qqqiiieee/fpga_gowin2/docs/V034到V047更新说明.md

# V034 → V047 更新说明

比较基线是仓库上一版提交 `d6295e39ca2d74b82c05a373665e5388a38f060b`，不是仅列 V046 到 V047 的变化。当前固件身份见根目录 manifest；中间版、对话、工具链缓存、Flash 个人数据备份不作为本次发布内容。

| 项目 | V034 | V047 |
|---|---|---|
| 手机 | 参数与预设 | 参数/只读遥测、曲谱上传激活与下载、128 音符映射及 Pad/CC 映射、录音回传 |
| 教学 | 三首固定曲的视觉时间轴 | 一首简单曲+两首复杂练习曲；自动发声、逐音练习、固定 BPM；另有上传自定义槽 |
| 和弦 | 旧单音指引 | score/2 同组 1–4 音、同组下落条、自动和弦、练习新 NoteOn 和同时 held 判定；兼容 score/1 |
| 32 路验证 | 内部引擎存在、生产无启动入口 | 长按3进入，短按4全32；逐路 OFF/ON 检查；频率核对表与展示说明 |
| 可视化 | 波形/音符摘要 | 最终 PCM FFT512、前两声部李萨如及自适应缩放、双 FSR/MIDI/光电诊断 |
| 面板 | 短按及长按1/2 | 增加长按3测试和长按4指导模式；逐页中文操作说明 |
| ADS | D14/E15 | 迁到 PMOD3 N9/N7，避让受损信号脚；增强复位/恢复 |
| 外接 I2S | B14/A15/B13 | B12/C12/B13；保留 PT8211；用户已反馈 I2S 输出实现 |
| Pad | 原混音电平 | 四鼓组 /4→/2，约 +6.02dB；旋律不变、保留饱和保护 |
| MIDI 状态 | 原展开实现 | 位图等价优化；保持完整0–127音域、来源释放、延音、Panic；差分回归已记录 |
| 录音存储 | 无 | LittleFS 顺序写 WAV 数据，readWavRange 合成44字节文件头；修复长录音封口问题 |

保留两种旋律音色、32 独立状态、双光电、双 FSR、四个 FX/音量旋钮。滑杆/MCP/矩阵及电容菜单仍停用；这部分主要变化已在上一版完成，不算本次新删功能。三效果仍互斥，并未增加三条并行效果链。

## 维护重点

1. FPGA/ESP 必须配套。能力字与 score/2 同步，旧 ESP V046 不识别新能力组合；HTTP 接收不等于 FPGA 提交成功。
2. 曲谱最多63组、每组1–4个升序唯一音高、MIDI41–72、四分之一拍网格、共享起始/时长、组间不重叠；不是任意多轨 MIDI。JSON velocity 当前不改变自动演奏固定力度192。
3. guide_chord_events 的来源3先 Off 再 On；guide_chord_modes 要求新触发且同时保持全部目标，踏板尾音不等于真实 held。
4. 映射只改变送合成器的音符；原始琴键高亮、练习判定与扫弦选音仍按物理 MIDI。修改须同时保护排队、NoteOff、延音和 Panic。
5. 录音不得恢复 seek(0) 改写大文件头；所有下载/USB读取走 readWavRange。录音15625Hz不是I2S的93750Hz。
6. N9 是复用脚，重建必须设置 use_sspi_as_gpio=1。禁用损坏脚清单与当前接线见接线文档。
7. 当前已有真实上传/下载、三模式状态与30秒非静音数字录音证据；模拟延迟、32路频谱、真实逐音和弦实弹、冷启动仍待确认。
8. 光电单束后备有150ms等待，不能对全部输入路径宣称≤10ms/≤5ms；应单独测试并改进。FFT/XY是只读监视，不应进入实时音频控制环。

## 资源变化与验证

| 资源 | V034 | V047 | 增量 |
|---|---:|---:|---:|
| Logic |16940|20381|+3441|
| Register |8100|9540|+1440|
| CLS |9510|10353|+843|
| BSRAM |27|41|+14|
| DSP |15.75|16.25|+0.5|

两版 Setup/Hold 均为0；V047主时钟Fmax27.03MHz，CLS余15。既有实机录音468750样本、937544字节、CRC32 a5efac56；这些数字证明数字音频回传，不证明模拟底噪或输入到声音的延迟。

本次 GitHub 发布沿用已验证二进制，不重新编译、不改板上内容。示例谱保持文件形式供手机上传；验证后设备自定义曲库已清空，不把演示新曲预烧进程序。
