qqqiiieee/fpga_gowin2/docs/V045_演奏界面预览.png

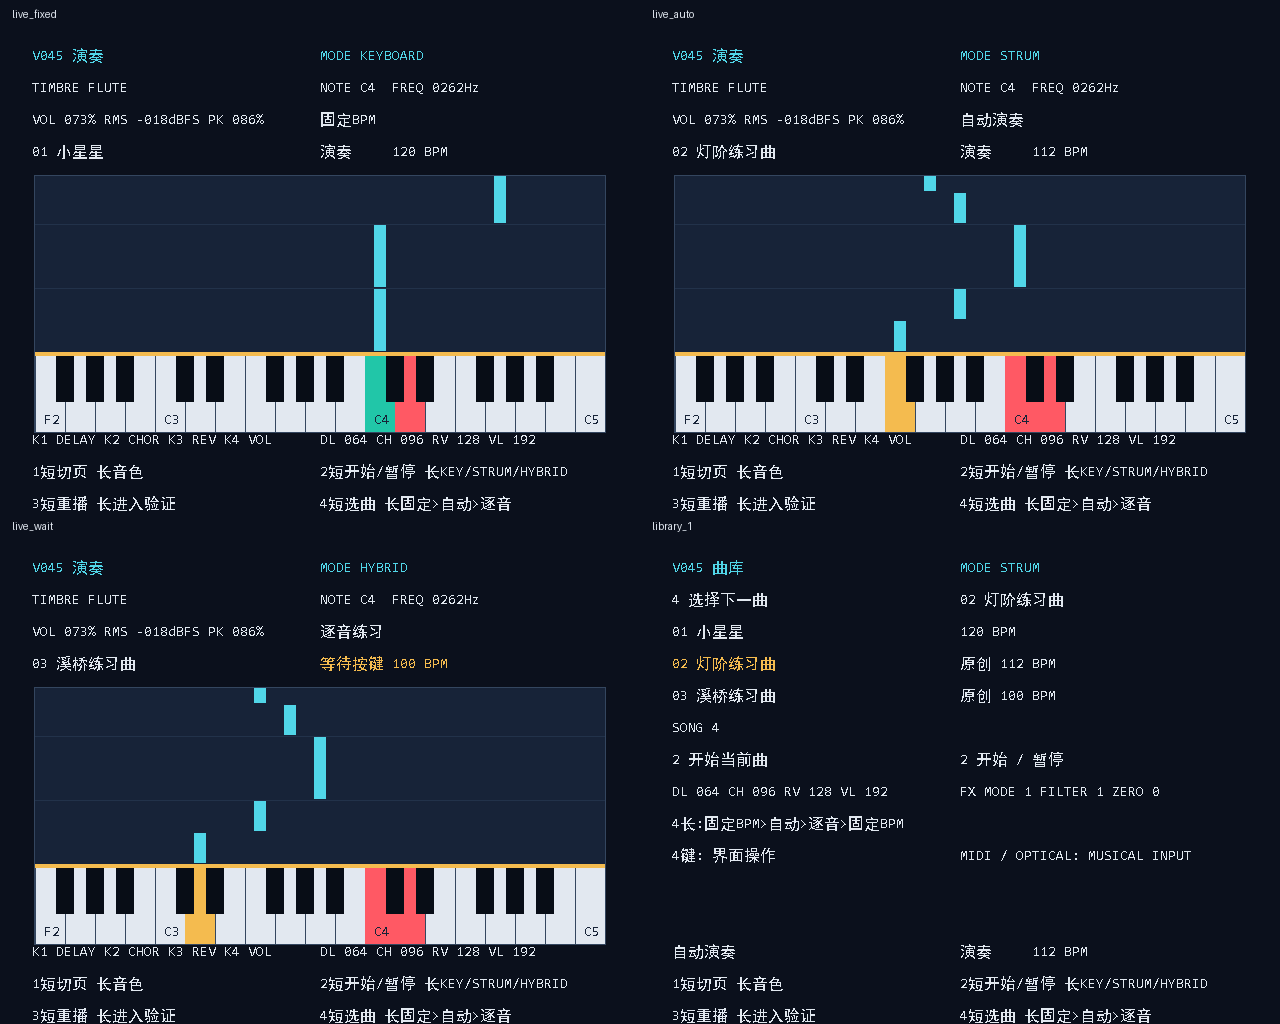
docs/V045_演奏界面预览.png
