qqqiiieee/fpga_gowin2/verification/guide_preview.png

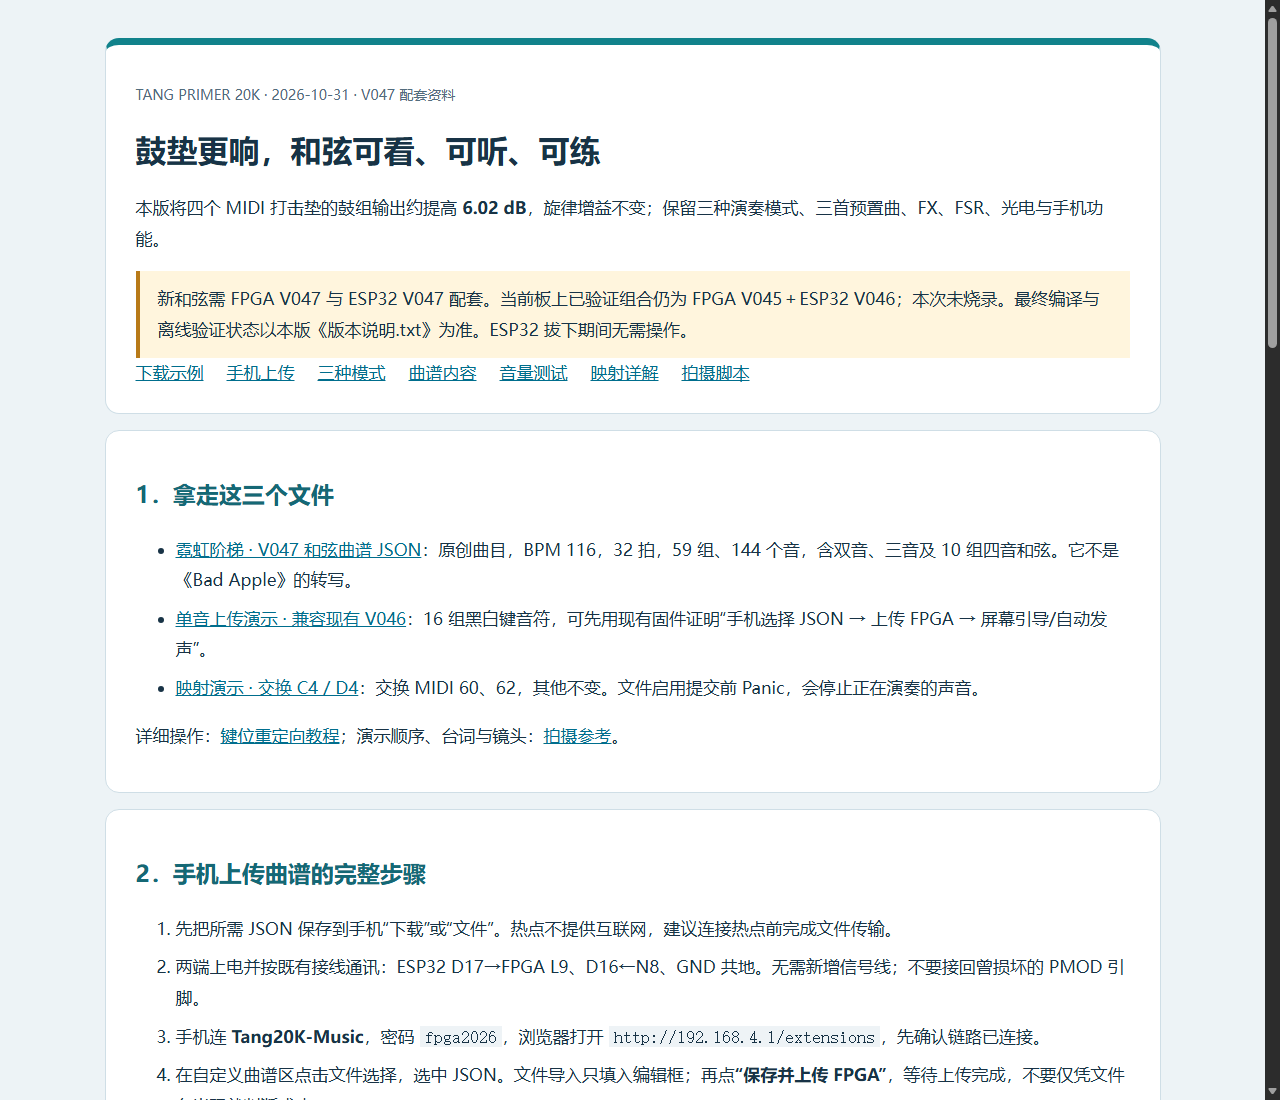
verification/guide_preview.png
