qqqiiieee/fpga_gowin2/tests/pad_gain_v047/README.md

# V047 四 MIDI 鼓垫增益验证

生产改动仅 `src/performance_mixer.v`：`drums_sum >>> 2` 改为 `>>> 1`。
四鼓先有符号求和再统一放大，未改单鼓、力度映射、旋律乘积、平衡平滑、流水线和末级饱和。
默认 balance=128：鼓组由 sum/8 改为 sum/4；旋律仍为 melody/2。
两个原有乘法表达式及所有寄存器位宽保持不变，没有增加乘法器。

## 位宽与真实上游

- 任意四路 PCM16 求和范围 -131072..131068，18 位有符号完整保存。
- 除 2 后 -65536..65534；乘最大平衡 255 后 -16711680..16711170，现有 26 位乘积足够。
- 与旋律在原 27 位加法寄存器相加，最后除 256 并饱和为 -32768..32767，不能先截成 16 位。
- `drum_voice.v` 三角幅值与包络给出绝对峰值 ≤8159；`snare_voice.v` 的噪声+主体 ≤8158；两种 `hat_voice.v` 各 ≤8159。
- 因而真实四鼓即便所有理论峰值同相，总和绝对值 ≤32635，除 2 后在 -16318..16317 内。
  和任意合法旋律 PCM 用互补平衡权重混合不会新增饱和；人为全量程四鼓仍由原饱和器保护。
- MIDI 原映射 `{v7,v7[6]}`、FX 和总音量链路从当前本地源码检查，未改动。

## 本次结果

有效记录：`results/20261031T112653_828232Z/report.json`，也复制到 `latest_report.json`。
采样率按生产音频 93750 Hz 解读；每例 60400 帧覆盖开镲完整尾音及复触发。
以下为冷启动、力度255、默认平衡128，在混音器输出处测量的 PCM 整数幅值：

| 输入 | 真实上游峰值 | 旧输出峰值 | 新输出峰值 | 新输出 RMS |
|---|---:|---:|---:|---:|
| 底鼓 | 7874 | 984 | 1968 | 157.61 |
| 军鼓 | 4875 | 609 | 1218 | 55.32 |
| 闭镲 | 5917 | 740 | 1480 | 85.28 |
| 开镲 | 6081 | 761 | 1521 | 242.90 |
| 四鼓同时 | 20777 | 2597 | 5194 | 349.56 |

上述 RMS 增益均约 +6.02 dB。力度 0/2/64/129/192/255 的四鼓输出峰值分别为
0/40/1303/2627/3910/5194，RMS 严格递增。力度2的 RMS 增益约5.83 dB，源于原有整数右移量化；未改为取绝对值或无符号移位。

- 算术：417903组通过，包括六个平衡点穷举全部65536个旋律值、全部256个平衡码的四鼓符号角点、10000组固定种子随机输入和奇数负值。
- 395524组无鼓输入与冻结旧版逐位相同；复位、无tick保持、三拍后发布/四级处理时序、平衡每帧一码均检查。
- 人工边界命中正饱和520次、负饱和1521次，均符合独立32位整数参考，没有正负回绕。
- 真实四鼓：5073600次逐样本检查，涵盖六档力度、平衡128/255、错开击打、尾音期间64→255复触发，以及叠加正负满量程旋律；全部零饱和。
- 长波形用8 clk/tick加速空闲周期；另用真实288 clk/tick跑2048帧，原始四鼓/新旧混音序列和统计与8 clk版本逐字节一致，bench断言实际tick间隔。
- FX：真实 `audio_effects` 的旁路/Delay/Chorus/Reverb共16384帧，288 clk/tick，带变动平衡与正负旋律，新旧输出和tail_busy每clk逐位相同；三个湿声模式都实际产生湿声。

运行：`python tests/pad_gain_v047/run_tests.py`。工具默认读取既有
`D:/Gowin_project/instrument_expression_20261024/tools/vendor/iverilog-v12/app/bin`，可用 `--tools` 覆盖。
输入快照、SHA256、工具哈希、命令、编译警告、输出日志、波形CSV及完整测量均在本目录。
早一轮运行因修正测试台tick间隔而中止，保留记录，不能作为最终通过证据。

## 边界

这是 RTL 仿真测量，不是物理耳机响度或板上验证。未构建全工程、未综合/P&R、未生成或烧录固件、未发布。
CLS/Fmax/DSP实际映射未经本任务验证，父流程需确认近满器件的余量；固定移位改动并不构成资源不变的实测证据。
并发父任务修改了其它src，报告单列其哈希变化；本任务的生产写入仅混音器。
