qqqiiieee/fpga_gowin2/tests/custom_score/latest_report.txt

D:\Gowin_project\instrument_phone_extensions_20261031\tests\custom_score\artifacts\20261031T095223_446308Z\summary.json
