qqqiiieee/fpga_gowin2/verification/mapping_preview.png

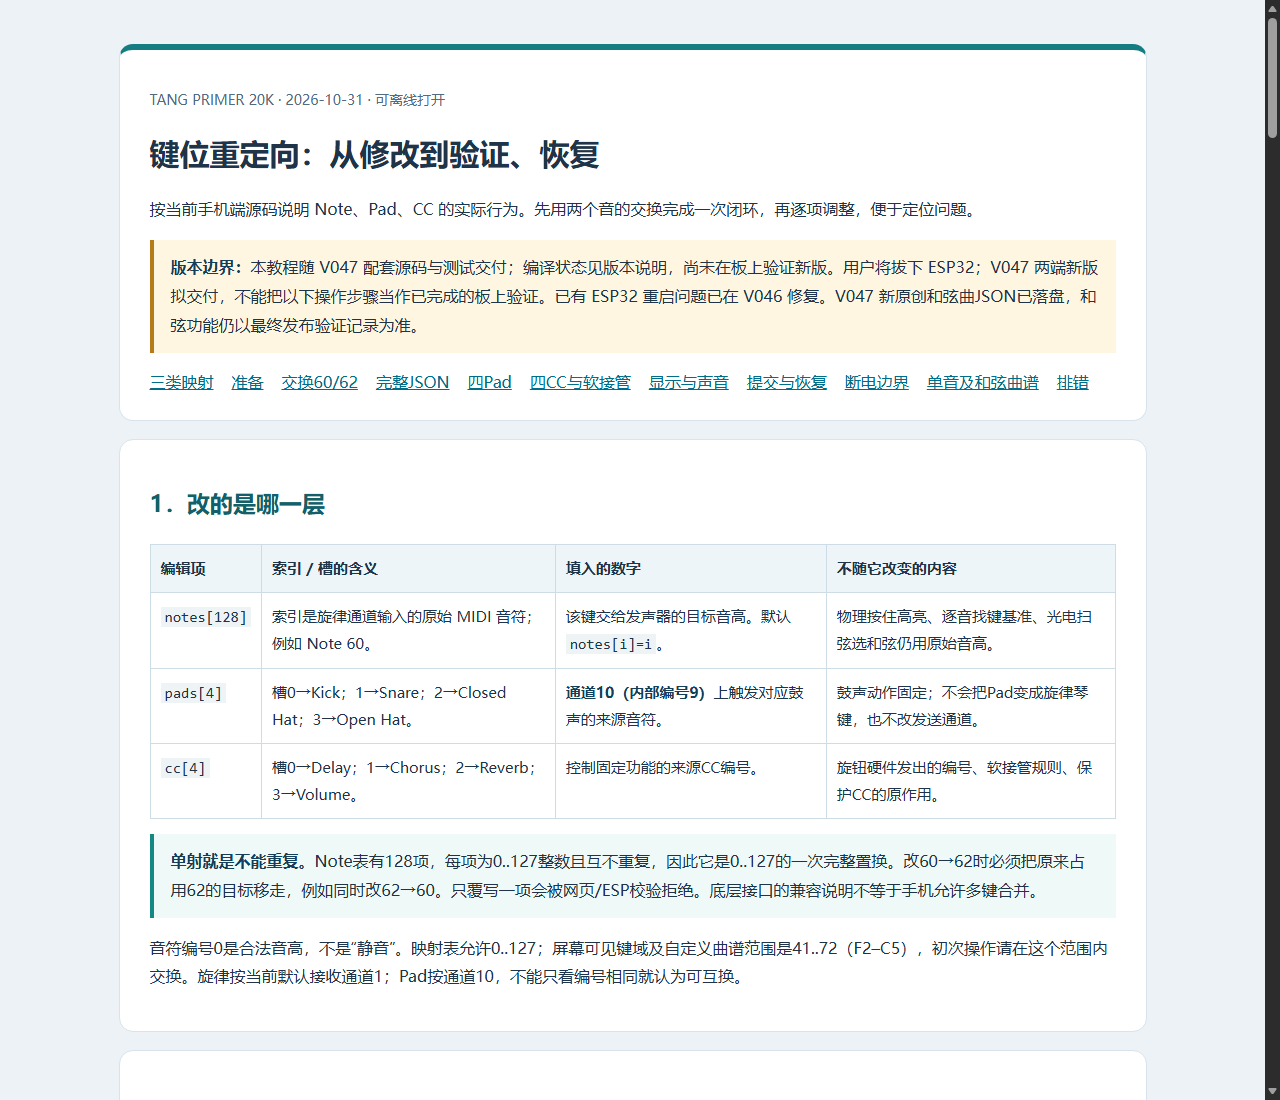
verification/mapping_preview.png
