qqqiiieee/fpga_gowin2/verification/video_preview.png

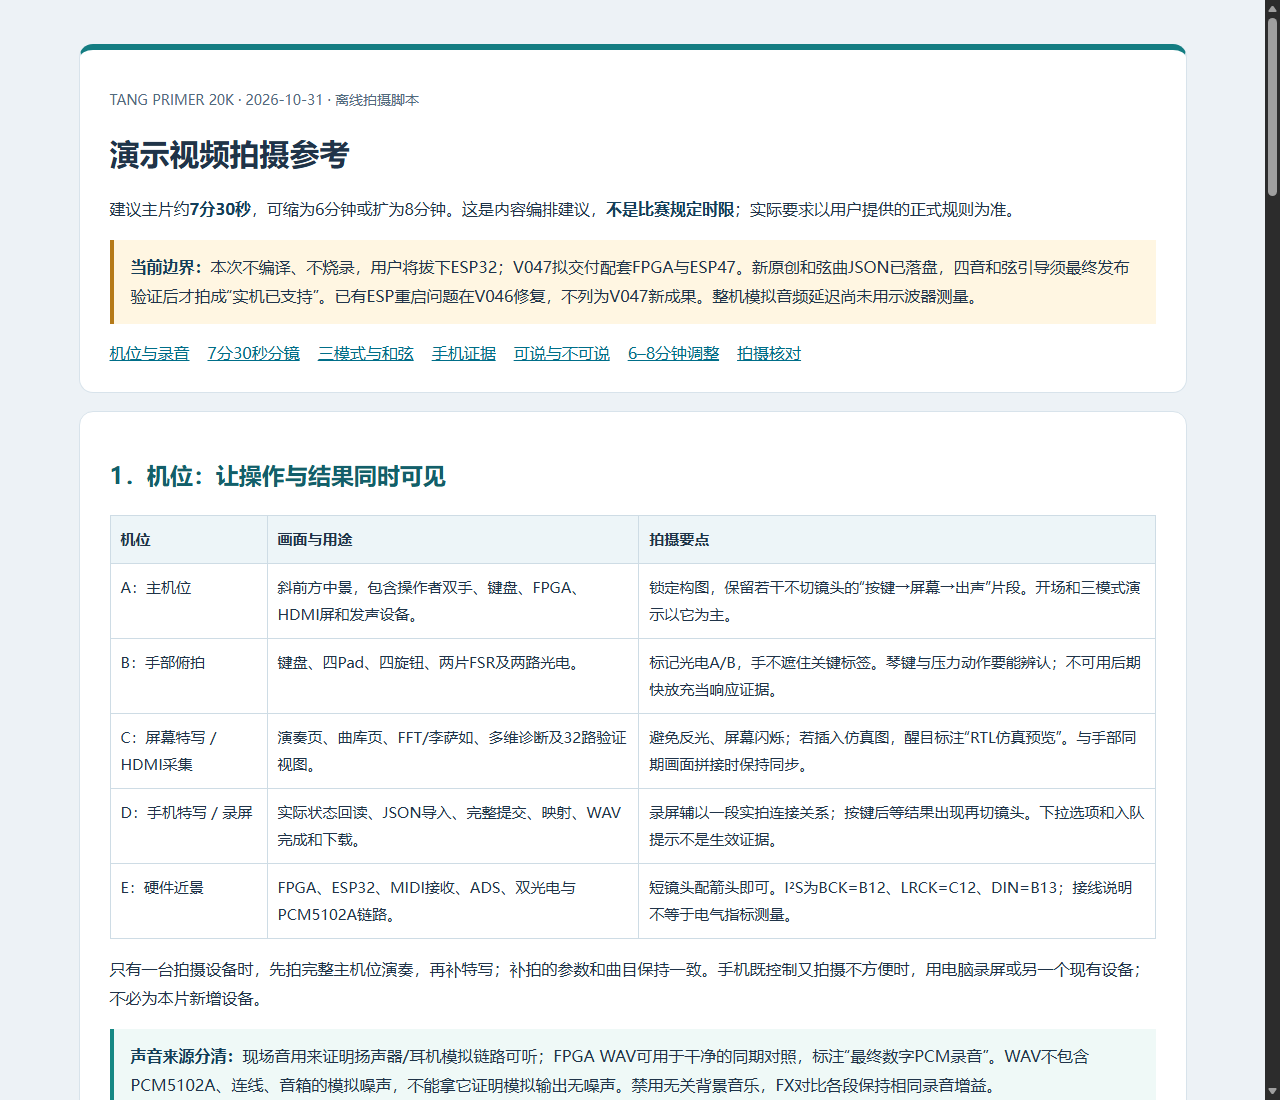
verification/video_preview.png
