qqqiiieee/fpga_gowin2/verification/ESP编译日志.txt

Sketch uses 927701 bytes (70%) of program storage space. Maximum is 1310720 bytes.
Global variables use 97160 bytes (29%) of dynamic memory, leaving 230520 bytes for local variables. Maximum is 327680 bytes.
