qqqiiieee/fpga_gowin2/verification/布局布线日志.txt

Reading netlist file: "D:\Gowin_project\instrument_phone_extensions_20261031\impl\gwsynthesis\instrument_handoff.vg"
Parsing netlist file "D:\Gowin_project\instrument_phone_extensions_20261031\impl\gwsynthesis\instrument_handoff.vg" completed
Processing netlist completed
Reading constraint file: "D:\Gowin_project\instrument_phone_extensions_20261031\src\multi_tone.cst"
Physical Constraint parsed completed
Running placement......
[10%] Placement Phase 0 completed
[20%] Placement Phase 1 completed
[30%] Placement Phase 2 completed
[50%] Placement Phase 3 completed
Running routing......
[60%] Routing Phase 0 completed
[70%] Routing Phase 1 completed
[80%] Routing Phase 2 completed
[90%] Routing Phase 3 completed
Running timing analysis......
[95%] Timing analysis completed
Placement and routing completed
Bitstream generation in progress......
Bitstream generation completed
Running power analysis......
[100%] Power analysis completed
Generate file "D:\Gowin_project\instrument_phone_extensions_20261031\impl\pnr\instrument_handoff.power.html" completed
Generate file "D:\Gowin_project\instrument_phone_extensions_20261031\impl\pnr\instrument_handoff.pin.html" completed
Generate file "D:\Gowin_project\instrument_phone_extensions_20261031\impl\pnr\instrument_handoff.rpt.html" completed
Generate file "D:\Gowin_project\instrument_phone_extensions_20261031\impl\pnr\instrument_handoff.rpt.txt" completed
Generate file "D:\Gowin_project\instrument_phone_extensions_20261031\impl\pnr\instrument_handoff.tr.html" completed
Generate file "D:\Gowin_project\instrument_phone_extensions_20261031\impl\pnr\instrument_handoff.tr" completed
Sat Oct 31 19:45:13 2026
