qqqiiieee/fpga_gowin2/src/hdmi_live_display.v

// 显示封装：源域27MHz、像素25.2MHz、DDR串行126MHz；锁定后各域分别释放复位。
// sample_tick是源域时钟使能，pcm为16位二补码；pixel域只读取整帧状态与双缓冲波形。
// UI_ENABLE默认0保留242bit旧接口，=1增加高10bit页/游标/曲目/控制键。
// COMPACT_UI默认0兼容旧图；=1隐含开启四页元数据并增加37位，共289位整包跨域。
// strum_mode[1:0]：0=KEY、1=STRUM、2=HYBRID；模式与其余状态整包跨域。
// HYBRID_MODE_ENABLE=1仅在compact分支最高位追加混合模式标志，不移动任何旧字段。
// knob_values从低到高每8位对应K1..K4；与页、模式、旧状态同次握手，只在帧边界发布。
// 低242bit打包与解包顺序必须匹配，见下方布局；不要为多位状态逐位双触发器同步。
// source_status由req/ack整包握手捕获，display_status仅frame_tick帧边界切换。
// 旧分支波形RAM一拍、字体一拍、RGB一拍，共三拍；COMPACT增加字符ROM一拍，共四拍。
// 两分支各自的字色、背景、RGB与DE/HS/VS共同延迟；不修改原波形地址/采样率。
// 复位立即断言且每域同步释放；PLL失锁清空显示状态但不复位音频层。
// peak保留接口但当前波形缩放取capture_peak；不要为了消除未用端口而改所有位置调用。
// 输出为兼容DVI的视频TMDS，没有HDMI音频包、HDCP或USB触控。

// Instrument status crosses domains as a coherent frame-boundary snapshot.
// The scope uses immutable RAM banks with its own request/ack handshake.
module hdmi_live_display #(parameter UI_ENABLE=0,parameter COMPACT_UI=0,
 parameter PIANO_ROLL_ENABLE=0,parameter HYBRID_MODE_ENABLE=0,
 parameter EXPRESSION_UI_ENABLE=0,parameter VISUALIZATION_ENABLE=0,
 parameter CUSTOM_SCORE_ENABLE=0,parameter SONG_LIBRARY_ENABLE=0)(
 input clk27,input rst_n,input sample_tick,input [15:0] pcm,peak,
 input [11:0] keys,input [3:0] timbre,input [6:0] note,input note_valid,
 input [15:0] frequency_bcd,input [7:0] volume_percent,
 input signed [7:0] level_dbfs,input [7:0] peak_percent,
 input signed [8:0] pitch,input [5:0] voices,input [7:0] pressure0,pressure1,flags,
 input guide_active,guide_done,input [11:0] cue_mask,next_mask,wrong_mask,
 input [5:0] guide_step,guide_total,input [7:0] beat_progress,
 input [1:0] target_beats,input clip,
 output tmds_clk_p,tmds_clk_n,output [2:0] tmds_data_p,tmds_data_n,
 output pll_locked,output frame_tick,
 // 测试页新增 78 位：1+6+32+32+1+5+1；全部由音频源时钟域的父模块提供。
 // test_active 表示测试引擎持有音频通路，包含进入/退出交接，不能仅接测试按键。
 // requested 为请求振荡器数（0..32）；busy/gate 的 bit i 对应第 i 路（0..31）。
 // busy 包含释放尾音；gate 是当前门控请求，两者必须分别显示。
 // sweep/index 为扫频模式和当前 0..31 索引；overrun 是测试调度超时状态。
 // voices 在测试期间应由父模块对 busy 计数，保持“请求数/实际活动数”的区别。
 input test_active,input [5:0] test_requested,
 input [31:0] test_busy,test_gate,input test_sweep,
 input [4:0] test_index,input test_overrun,
 input [1:0] ui_page,ui_cursor,ui_song,input [3:0] ui_controls,
 input [1:0] control_page,fx_mode,input [1:0] strum_mode,input [31:0] knob_values,
 // Physical held MIDI41..72 (F2..C5), distinct from panel keys and oscillator busy.
 input [31:0] piano_keys,input piano_outside,
 input [11:0] roll_tick,input [1:0] roll_song,input roll_active,roll_done,
 // V035只读诊断；不是新增音源控制，也不把两个FSR读数相加。
 // ADC低16位=FSR0/高16位=FSR1，保留ADS二补码原始码，用HEX显示而非kg。
 // velocity是最近有效NoteOn的原始MIDI力度0..127；bend是-256..255控制值，
 // modulation为MIDI CC1原值0..127。calibrated各位分别对应FSR0/FSR1。
 input [31:0] expression_adc,input [1:0] expression_calibrated,
 input [7:0] midi_velocity,input signed [8:0] midi_bend,input [6:0] midi_modulation,
 // V036：最终PCM的FFT与独立声部0/1的XY，均为只读观察，独立双缓冲CDC。
 input signed [15:0] visual_voice0,visual_voice1,
 // Broadcast unchanged to source guide + pixel RAM. Config is SOURCE-domain;
 // renderer owns the held-bus/toggle transfer and atomic frame publication.
 // ACK remains a pixel-domain level: top/controller must synchronise TWICE
 // into clk27 and reject BEGIN while ack != custom_config[31].
 input custom_write_clk,input custom_write_en,
 input [8:0] custom_write_addr,input [31:0] custom_write_data,
 input [31:0] custom_config,output custom_bank_ack,
 // V045 source-domain status; appended to the SAME frame-snapshot mailbox.
 // 0=fixed BPM, 1=automatic, 2=note-by-note. Unconnected is ignored at feature0.
 input [1:0] guide_mode,input practice_wait);
 localparam USE_COMPACT=COMPACT_UI || PIANO_ROLL_ENABLE;
 wire serial_clk,pixel_clk;
 hdmi_clocks u_clocks(clk27,rst_n,serial_clk,pixel_clk,pll_locked);
 wire common_reset_n=rst_n && pll_locked;
 (* syn_preserve=1 *) reg [2:0] source_reset_sync,pixel_reset_sync;
 always @(posedge clk27 or negedge common_reset_n)
  if(!common_reset_n)source_reset_sync<=0;
  else source_reset_sync<={source_reset_sync[1:0],1'b1};
 always @(posedge pixel_clk or negedge common_reset_n)
  if(!common_reset_n)pixel_reset_sync<=0;
  else pixel_reset_sync<={pixel_reset_sync[1:0],1'b1};
 wire video_rst_n=pixel_reset_sync[2];
 wire [9:0] x,y;
 wire de,hsync,vsync;
 video_timing u_timing(pixel_clk,video_rst_n,x,y,de,hsync,vsync,frame_tick);
 // 原乐器/教学状态 164 位 + 测试状态 78 位 = 242 位。
 // 不能对新增字段逐位同步：页面所有权、掩码、计数、索引必须来自同一次握手快照。
 // 原字段顺序不变；测试字段追加到低 78 位，打包和解包严格使用同一顺序。
 // 低位布局：[77] active，[76:71] requested，[70:39] busy，[38:7] gate，
 // [6] sweep，[5:1] index，[0] overrun；仅在帧边界使用已应答的整包数据。
 // COMPACT implies the four-page metadata even when UI_ENABLE is omitted.
 // 289-bit compact packet: [288:287] control page, [286:285] FX,
 // [284] strum, [283:252] K4..K1. Low252 bits remain exactly compatible.
 // Feature=0 preserves 242/252/289 bits exactly, with no extra CDC registers.
 // Feature=1 implies compact and appends49 bits to the SAME bundled handshake:
 // [337:306] piano_keys, [305] outside, [304:293] tick, [292:291] song,
 // [290] active, [289] done. Low289 bits remain the compact legacy layout.
 localparam BASE_STATUS_WIDTH=164+78+((UI_ENABLE || USE_COMPACT) ? 10 : 0)+(USE_COMPACT ? 37 : 0);
 // The old strum bit means optical input enabled (STRUM or HYBRID). The
 // optional new top bit distinguishes HYBRID in the same coherent snapshot.
 // Parameter0 preserves the historical widths242/252/289/338 exactly;
 // parameter1 adds one bit only for compact:290, or339 with piano enabled.
 localparam PIANO_STATUS_WIDTH=BASE_STATUS_WIDTH+(PIANO_ROLL_ENABLE ? 49 : 0);
 localparam USE_HYBRID=USE_COMPACT && HYBRID_MODE_ENABLE;
 localparam HYBRID_STATUS_WIDTH=PIANO_STATUS_WIDTH+(USE_HYBRID ? 1 : 0);
 // 只在compact启用时追加58位到原有整包之上；默认0完全保留旧字段与宽度。
 // 生产piano+hybrid布局低339位不变；397位新包顶部为：
 // [396:365]ADC [364:363]cal [362:355]velocity [354:346]bend [345:339]mod。
 localparam USE_EXPRESSION=USE_COMPACT && EXPRESSION_UI_ENABLE;
 localparam EXPRESSION_STATUS_WIDTH=HYBRID_STATUS_WIDTH+(USE_EXPRESSION ? 58 : 0);
 localparam USE_CUSTOM=PIANO_ROLL_ENABLE && CUSTOM_SCORE_ENABLE;
 // A single extra tag travels with time/song/page in the existing coherent
 // snapshot. It prevents rendering the new bank at the previous bank's tick
 // if the independent config mailbox reaches a frame before u_status does.
 // Default0 retains ALL previous 242/252/289/338/... packet layouts.
 localparam CUSTOM_STATUS_WIDTH=EXPRESSION_STATUS_WIDTH+(USE_CUSTOM ? 1 : 0);
 localparam USE_SONG_LIBRARY=USE_COMPACT && SONG_LIBRARY_ENABLE;
 // Keep every old bit (including the custom bank tag) at its original offset.
 // Production piano+hybrid+expression+custom: [400:399]mode [398]wait,
 // [397]custom bank, [396:0]unchanged. Feature0 retains the old exact width.
 localparam STATUS_WIDTH=CUSTOM_STATUS_WIDTH+(USE_SONG_LIBRARY ? 3 : 0);
 wire [241:0] legacy_source_status={
  keys,timbre,note,note_valid,frequency_bcd,volume_percent,level_dbfs,peak_percent,
  pitch,voices,pressure0,pressure1,flags,guide_active,guide_done,cue_mask,next_mask,
  wrong_mask,guide_step,guide_total,beat_progress,target_beats,clip,
  test_active,test_requested,test_busy,test_gate,test_sweep,test_index,test_overrun};
 // 旧 242-bit 接口与四页 252-bit 接口显式选择，消除隐式截断依赖。
 wire [BASE_STATUS_WIDTH-1:0] base_source_status;
 wire [PIANO_STATUS_WIDTH-1:0] piano_source_status;
 wire [HYBRID_STATUS_WIDTH-1:0] hybrid_source_status;
 wire [EXPRESSION_STATUS_WIDTH-1:0] expression_source_status;
 wire [CUSTOM_STATUS_WIDTH-1:0] custom_source_status;
 wire [STATUS_WIDTH-1:0] source_status;
 generate if(USE_COMPACT)begin:source_compact_packet
  assign base_source_status={control_page,fx_mode,(strum_mode!=2'd0),knob_values,
   ui_page,ui_cursor,ui_song,ui_controls,legacy_source_status};
 end else if(UI_ENABLE)begin:source_ui_packet
  assign base_source_status={ui_page,ui_cursor,ui_song,ui_controls,legacy_source_status};
 end else begin:source_legacy_packet
  assign base_source_status=legacy_source_status;
 end endgenerate
 generate if(PIANO_ROLL_ENABLE)begin:source_piano_packet
  assign piano_source_status={piano_keys,piano_outside,roll_tick,roll_song,roll_active,roll_done,base_source_status};
 end else begin:source_no_piano_packet
  assign piano_source_status=base_source_status;
 end endgenerate
 generate if(USE_HYBRID)begin:source_hybrid_packet
  assign hybrid_source_status={(strum_mode==2'd2),piano_source_status};
 end else begin:source_no_hybrid_packet
  assign hybrid_source_status=piano_source_status;
 end endgenerate
 generate if(USE_EXPRESSION)begin:source_expression_packet
  assign expression_source_status={expression_adc,expression_calibrated,midi_velocity,
   midi_bend,midi_modulation,hybrid_source_status};
 end else begin:source_no_expression_packet
  assign expression_source_status=hybrid_source_status;
 end endgenerate
 wire d_roll_custom_bank;
 generate if(USE_CUSTOM)begin:custom_timeline_tag
  reg source_bank;
  // Same edge as guide's synchronous config detection/restart. Thus a held
  // status snapshot sees either old tick+old tag or restarted tick+new tag.
  always @(posedge clk27 or negedge source_reset_sync[2])
   if(!source_reset_sync[2])source_bank<=0;
   else source_bank<=custom_config[31];
  assign custom_source_status={source_bank,expression_source_status};
  assign d_roll_custom_bank=display_status[CUSTOM_STATUS_WIDTH-1];
 end else begin:no_custom_timeline_tag
  assign custom_source_status=expression_source_status;assign d_roll_custom_bank=0;
 end endgenerate
 wire [1:0] d_guide_mode;
 wire d_practice_wait;
 generate if(USE_SONG_LIBRARY)begin:song_library_metadata
  assign source_status={guide_mode,practice_wait,custom_source_status};
  assign {d_guide_mode,d_practice_wait}=display_status[STATUS_WIDTH-1:CUSTOM_STATUS_WIDTH];
 end else begin:no_song_library_metadata
  assign source_status=custom_source_status;
  assign {d_guide_mode,d_practice_wait}=3'd0;
 end endgenerate
 wire [STATUS_WIDTH-1:0] display_status;
 hdmi_status_cdc #(.WIDTH(STATUS_WIDTH)) u_status(clk27,source_reset_sync[2],source_status,
  pixel_clk,video_rst_n,frame_tick,display_status);
 wire [11:0] d_keys,d_cue,d_next,d_wrong;
 wire [3:0] d_timbre;
 wire [6:0] d_note;
 wire d_note_valid,d_active,d_done,d_clip;
 wire [15:0] d_frequency;
 wire [7:0] d_volume,d_peak,d_pressure0,d_pressure1,d_flags,d_progress;
 wire signed [7:0] d_level;
 wire signed [8:0] d_pitch;
 wire [5:0] d_voices,d_step,d_total;
 wire [1:0] d_beats;
 wire d_test_active,d_test_sweep,d_test_overrun;
 wire [5:0] d_test_requested;
 wire [31:0] d_test_busy,d_test_gate;
 wire [4:0] d_test_index;
 assign {d_keys,d_timbre,d_note,d_note_valid,d_frequency,d_volume,d_level,d_peak,
  d_pitch,d_voices,d_pressure0,d_pressure1,d_flags,d_active,d_done,d_cue,d_next,
  d_wrong,d_step,d_total,d_progress,d_beats,d_clip,
  d_test_active,d_test_requested,d_test_busy,d_test_gate,
  d_test_sweep,d_test_index,d_test_overrun}=display_status[241:0];
 // d_test_* 只在帧边界更新；过渡期间仍显示 OSC TEST，避免半帧混入普通页面。
 // Physical clipping and audio engine overrun share the ALERT flag in the UI.
 wire [7:0] alert_flags=d_flags | (d_clip?8'h80:8'h00);
 wire [7:0] scope_addr=(x-10'd32)>>1;
 wire signed [15:0] scope_current,scope_previous;
 wire [3:0] scope_gain;
 wire scope_valid;
 wave_scope u_scope(clk27,source_reset_sync[2],sample_tick,pcm,
  pixel_clk,video_rst_n,frame_tick,scope_addr,scope_current,scope_previous,scope_gain,scope_valid);
 // RAM has one synchronous read cycle. Raster and control follow that delay.
 reg [9:0] draw_x,draw_y;
 reg draw_de,draw_hs,draw_vs;
 always @(posedge pixel_clk or negedge video_rst_n)begin
  if(!video_rst_n)begin draw_x<=0;draw_y<=0;draw_de<=0;draw_hs<=1;draw_vs<=1;end
  else begin draw_x<=x;draw_y<=y;draw_de<=de;draw_hs<=hsync;draw_vs<=vsync;end
 end
 wire [7:0] r,g,b;
 wire [1:0] d_ui_page,d_ui_cursor,d_ui_song;
 wire [3:0] d_ui_controls;
 generate if(UI_ENABLE || USE_COMPACT)begin:ui_metadata
  assign {d_ui_page,d_ui_cursor,d_ui_song,d_ui_controls}=display_status[251:242];
 end else begin:legacy_metadata
  assign {d_ui_page,d_ui_cursor,d_ui_song,d_ui_controls}=10'd0;
 end endgenerate
 wire [7:0] legacy_r,legacy_g,legacy_b;
 // 编译期排除旧渲染器：COMPACT_UI=1时不展开其字体/译码/网格逻辑，
 // 不依赖后续死逻辑删除。COMPACT_UI=0保持原接口、RGB和三拍流水不变。
 // 历史bench仅需把层级绑定改为legacy_ui.u_dashboard，不修改任何像素预期。
 generate if(!USE_COMPACT)begin:legacy_ui
 hdmi_instrument_dashboard #(.UI_ENABLE(UI_ENABLE)) u_dashboard(
  .x(draw_x),.y(draw_y),.de(draw_de),.keys(d_keys),.timbre(d_timbre),
  .note(d_note),.note_valid(d_note_valid),.frequency_bcd(d_frequency),
  .volume_percent(d_volume),.level_dbfs(d_level),.peak_percent(d_peak),
  .pitch(d_pitch),.voices(d_voices),.pressure0(d_pressure0),.pressure1(d_pressure1),
  .flags(alert_flags),.guide_active(d_active),.guide_done(d_done),
  .cue_mask(d_cue),.next_mask(d_next),.wrong_mask(d_wrong),
  .guide_step(d_step),.guide_total(d_total),.beat_progress(d_progress),.target_beats(d_beats),
  .wave_current(scope_current),.wave_previous(scope_previous),
  .scope_gain(scope_gain),.wave_valid(scope_valid),.red(legacy_r),.green(legacy_g),.blue(legacy_b),
  .test_active(d_test_active),.test_requested(d_test_requested),
  .test_busy(d_test_busy),.test_gate(d_test_gate),.test_sweep(d_test_sweep),
  .test_index(d_test_index),.test_overrun(d_test_overrun),
  .pixel_clk(pixel_clk),.rst_n(video_rst_n),
  .ui_page(d_ui_page),.ui_cursor(d_ui_cursor),.ui_song(d_ui_song),.ui_controls(d_ui_controls));
 end endgenerate
 wire [1:0] d_control_page,d_fx_mode;
 wire d_strum_enabled;
 wire [1:0] d_strum_mode;
 wire [31:0] d_knob_values;
 wire [31:0] d_piano_keys;
 wire d_piano_outside,d_roll_active,d_roll_done;
 wire [11:0] d_roll_tick;
 wire [1:0] d_roll_song;
 wire [31:0] d_expression_adc;
 wire [1:0] d_expression_calibrated;
 wire [7:0] d_midi_velocity;
 wire signed [8:0] d_midi_bend;
 wire [6:0] d_midi_modulation;
 generate if(USE_EXPRESSION)begin:expression_metadata
  assign {d_expression_adc,d_expression_calibrated,d_midi_velocity,
   d_midi_bend,d_midi_modulation}=display_status[EXPRESSION_STATUS_WIDTH-1:HYBRID_STATUS_WIDTH];
 end else begin:no_expression_metadata
  assign {d_expression_adc,d_expression_calibrated,d_midi_velocity,
   d_midi_bend,d_midi_modulation}=58'd0;
 end endgenerate
 generate if(PIANO_ROLL_ENABLE)begin:piano_metadata
  assign {d_piano_keys,d_piano_outside,d_roll_tick,d_roll_song,d_roll_active,d_roll_done}=display_status[337:289];
 end else begin:no_piano_metadata
  assign {d_piano_keys,d_piano_outside,d_roll_tick,d_roll_song,d_roll_active,d_roll_done}=49'd0;
 end endgenerate
 generate if(USE_HYBRID)begin:hybrid_metadata
  assign d_strum_mode=display_status[HYBRID_STATUS_WIDTH-1] ? 2'd2 : {1'b0,d_strum_enabled};
 end else begin:no_hybrid_metadata
  assign d_strum_mode={1'b0,d_strum_enabled};
 end endgenerate
 wire [7:0] visual_fft_addr,visual_fft_level;
 wire [13:0] visual_xy_addr;
 wire visual_xy_dot,visual_fft_valid,visual_xy_valid;
 generate if(VISUALIZATION_ENABLE && USE_COMPACT)begin:visualization
  // 显示PLL失锁只复位分析/绘图支路；不连接音频复位或声音使能。
  audio_visual_buffers #(.XY_AUTO_SCALE(1)) buffers(.clk27(clk27),.source_rst_n(source_reset_sync[2]),
   .pixel_clk(pixel_clk),.pixel_rst_n(video_rst_n),.frame_tick(frame_tick),
   .sample_tick(sample_tick),.pcm(pcm),.voice0(visual_voice0),.voice1(visual_voice1),
   .fft_read_addr(visual_fft_addr),.xy_read_addr(visual_xy_addr),
   .fft_level(visual_fft_level),.xy_dot(visual_xy_dot),
   .fft_valid(visual_fft_valid),.xy_valid(visual_xy_valid));
 end else begin:no_visualization
  assign visual_fft_level=0;assign visual_xy_dot=0;
  assign visual_fft_valid=0;assign visual_xy_valid=0;
 end endgenerate
 generate if(USE_COMPACT)begin:compact_ui
  assign {d_control_page,d_fx_mode,d_strum_enabled,d_knob_values}=display_status[288:252];
  hdmi_compact_dashboard #(.PIANO_ROLL_ENABLE(PIANO_ROLL_ENABLE),
   .EXPRESSION_UI_ENABLE(EXPRESSION_UI_ENABLE),.VISUALIZATION_ENABLE(VISUALIZATION_ENABLE),
   .CUSTOM_SCORE_ENABLE(CUSTOM_SCORE_ENABLE),.SONG_LIBRARY_ENABLE(SONG_LIBRARY_ENABLE)) u_dashboard(
   .pixel_clk(pixel_clk),.rst_n(video_rst_n),.x(draw_x),.y(draw_y),.de(draw_de),
   .keys(d_keys),.timbre(d_timbre),.note(d_note),.note_valid(d_note_valid),
   .frequency_bcd(d_frequency),.volume_percent(d_volume),.level_dbfs(d_level),.peak_percent(d_peak),
   .voices(d_voices),.flags(alert_flags),.cue_mask(d_cue),.next_mask(d_next),.wrong_mask(d_wrong),
   .guide_step(d_step),.guide_total(d_total),.wave_current(scope_current),.wave_previous(scope_previous),
   .scope_gain(scope_gain),.wave_valid(scope_valid),.test_active(d_test_active),.test_requested(d_test_requested),
   .test_busy(d_test_busy),.test_gate(d_test_gate),.test_sweep(d_test_sweep),
   .test_index(d_test_index),.test_overrun(d_test_overrun),
   .ui_page(d_ui_page),.ui_cursor(d_ui_cursor),.ui_song(d_ui_song),.ui_controls(d_ui_controls),
   .control_page(d_control_page),.fx_mode(d_fx_mode),.strum_mode(d_strum_mode),.knob_values(d_knob_values),
   .red(r),.green(g),.blue(b),.piano_keys(d_piano_keys),.piano_outside(d_piano_outside),
   .roll_tick(d_roll_tick),.roll_song(d_roll_song),.roll_active(d_roll_active),.roll_done(d_roll_done),
   .expression_adc(d_expression_adc),.expression_calibrated(d_expression_calibrated),
   .midi_velocity(d_midi_velocity),.midi_bend(d_midi_bend),.midi_modulation(d_midi_modulation),
   .pressure0(d_pressure0),.pressure1(d_pressure1),
   .visual_fft_level(visual_fft_level),.visual_xy_dot(visual_xy_dot),
   .visual_fft_valid(visual_fft_valid),.visual_xy_valid(visual_xy_valid),
   .visual_fft_addr(visual_fft_addr),.visual_xy_addr(visual_xy_addr),
   .custom_write_clk(custom_write_clk),.custom_write_en(custom_write_en),
   .custom_write_addr(custom_write_addr),.custom_write_data(custom_write_data),
   .custom_config(custom_config),.frame_tick(frame_tick),
   .roll_custom_bank(d_roll_custom_bank),.custom_bank_ack(custom_bank_ack),
   .guide_mode(d_guide_mode),.practice_wait(d_practice_wait));
 end else begin:full_ui
  assign {d_control_page,d_fx_mode,d_strum_enabled,d_knob_values}=37'd0;
  assign {r,g,b}={legacy_r,legacy_g,legacy_b};
  assign custom_bank_ack=0;
 end endgenerate
 // 中文字模BRAM新增一拍；同步信号跟随字模背景同拍延迟。
 reg font_de,font_hs,font_vs;
 reg character_de,character_hs,character_vs;
 always @(posedge pixel_clk or negedge video_rst_n)begin
  if(!video_rst_n)begin
   font_de<=0;font_hs<=1;font_vs<=1;character_de<=0;character_hs<=1;character_vs<=1;
  end else begin
   font_de<=draw_de;font_hs<=draw_hs;font_vs<=draw_vs;
   character_de<=font_de;character_hs<=font_hs;character_vs<=font_vs;
  end
 end
 reg [23:0] rgb_pipe;
 reg de_pipe,hs_pipe,vs_pipe;
 always @(posedge pixel_clk or negedge video_rst_n)begin
  if(!video_rst_n)begin rgb_pipe<=0;de_pipe<=0;hs_pipe<=1;vs_pipe<=1;end
  else begin
   rgb_pipe<={r,g,b};de_pipe<=USE_COMPACT ? character_de : font_de;
   hs_pipe<=USE_COMPACT ? character_hs : font_hs;vs_pipe<=USE_COMPACT ? character_vs : font_vs;
  end
 end
 hdmi_tx u_tx(pixel_clk,serial_clk,video_rst_n,rgb_pipe[23:16],rgb_pipe[15:8],
  rgb_pipe[7:0],de_pipe,hs_pipe,vs_pipe,tmds_clk_p,tmds_clk_n,tmds_data_p,tmds_data_n);
endmodule
