qqqiiieee/fpga_gowin2/src/ads1115_reader.v

// 模块职责：轮询 ADS1115 单次转换，组合完整的两个转换字节后发布样本；
// 任一字节出错就丢弃整次转换，经等待和总线恢复后从 A0 重新开始。
// 通道约定：A0/A1 为两路压力，A2 为总音量，A3 为旋律音高控制。
// 本模块仅给出通道号和原始 ADC 码，不计算压力触发、音量或音高。
// ADC 码也不是 kg：由电压推导力/质量还需要传感器、模拟前端和实际标定。
// 端口：clk 为系统时钟；rst_n 为异步低有效复位；scl/sda 为带外部上拉的
// I2C 双向线。sample_valid 为一个 clk 周期的样本脉冲，sample_channel 为
// 0..3 的 AIN 编号，sample_data 为 ADS1115 16 位二补码，fault 为故障状态。
// fault 复位置 1，只有完整读数且最终 STOP 成功才清 0；不是单拍错误脉冲。
// 时序参数均以 clk 周期计：默认按 27MHz 使用，I2C_QUARTER=68 对应约
// 100kHz；CONVERT_CYCLES=40500 为 1.5ms，RETRY_CYCLES 为 100ms，
// BYTE_TIMEOUT_CYCLES 为每条字节命令/整次恢复各自的 10ms 超时上限。
// 配置为单端输入、ADC 量程 ±4.096V、860SPS，1 LSB=4.096V/32768=125uV。
// 量程并不表示可把输入接到 ±4.096V：本系统 3.3V 信号实际最大约 26400 码；
// A0..A3 的预期有效码为非负。这里原样传递符号位，不在读取端限幅。
// 状态机：RECOVER_ISSUE/WAIT -> ISSUE/WAIT_BYTE -> CONVERT -> 读寄存器；
// 错误经 DELAY 后再恢复。复位只复位 FPGA 逻辑，不能复位外部 ADC。
// 无外部 clock enable，状态机每个 clk 推进；I2C 节拍由下层计数器产生。
// PRESSURE_PRIORITY/PRESSURE_ONLY 默认均为0，作为布尔选项；ONLY 优先。
// 时间参数须为正，主等待和下层I2C计数器分别按参数自动定宽。
// 缩短转换等待须依据ADC转换时序，不能把减少位宽视为已验证加速。
// ADS1115 ADDR=GND (0x48), AIN0..3 single-ended, +/-4.096V, 860 SPS.
// Start each single conversion, wait >=1.5ms, then read register 0.
module ads1115_reader #(
    parameter I2C_QUARTER=68, parameter CONVERT_CYCLES=40500,
    parameter RETRY_CYCLES=2700000,parameter PRESSURE_PRIORITY=0,
    parameter PRESSURE_ONLY=0, parameter BYTE_TIMEOUT_CYCLES=270000
)(input clk,input rst_n,inout scl,inout sda,
  output reg sample_valid,output reg [1:0] sample_channel,
  output reg [15:0] sample_data,output reg fault);
    localparam RECOVER_ISSUE=0,RECOVER_WAIT=1,DELAY=2,ISSUE=3,WAIT_BYTE=4,CONVERT=5;
    reg [2:0] state;
    // 同一计时器复用重试与转换等待，宽度取较大门槛；不缩短ADC等待。
    localparam TIMER_LIMIT=(RETRY_CYCLES>CONVERT_CYCLES)?RETRY_CYCLES:CONVERT_CYCLES;
    localparam TIMER_WIDTH=(TIMER_LIMIT>1)?$clog2(TIMER_LIMIT):1;
    reg [TIMER_WIDTH-1:0] timer;
    reg [1:0] channel;
    reg [2:0] schedule_step;
    reg reading;
    reg [3:0] step;
    reg command_valid;
    reg [1:0] command;
    reg [7:0] tx;
    reg read_nack;
    reg [7:0] high_byte,low_byte;
    wire busy,done,byte_error;
    wire [7:0] rx;
    reg recovery_start,byte_enable;
    // 两个引擎均只能拉低或释放 SCL/SDA，绝不能强推高电平。
    // byte_enable 是寄存的总线所有权：恢复/重试时字节引擎持续复位并释放线，
    // 避免它停留在 SCL 拉低状态而阻碍恢复引擎的九个物理时钟脉冲。
    wire recovery_busy,recovery_done,recovery_error;
    // Exclusive bus ownership: reset releases the byte engine's open drains
    // throughout recovery/retry. A reset of this reader never resets the slave.
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
