qqqiiieee/fpga_gowin2/(commit log)

2026-10-01 初始版本：8声部多音色合成乐器引擎
    - 8 声部复音 + ADSR 包络 + 4 音色（正弦/方波/锯齿/三角）
    - 正弦 256 点全周期波表 + 线性插值（消除沙沙声）
    - PT8211 DAC 驱动（LSBJ，约 52.7kHz 采样率）
    - 按键去抖触发 + 复音分配器 + 混音器
    - 引脚约束、工程文件、README
2026-10-12 发布 V015 乐器工程与最新架构交接文档
2026-10-30 发布 V034：MIDI/光电混合、手机控制与完整架构交接
    基于上一份 GitHub V015（c07e7d1）更新当前工程与配套 FPGA/ESP32 固件，不上传中间发布目录、对话记录或本机工具链。
    旋律音色从16种收敛为长笛/拨弦两种，保留32独立声部；MIDI与双光束提供KEY/STRUM/HYBRID。双FSR改为明亮度/拨弦阻尼，滑杆和矩阵/电容菜单停用。四键长短按、三效果旋钮与音量、F2-C5真实钢琴下落指引、手机UART实际回读及外接I2S均纳入当前版本。
    补充V015到V034功能与资源差异、模块架构、人类/AI交接、协议与部署说明；整理便携离线回归、源/固件校验和构建证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
2026-10-31 发布 V047：手机曲谱映射录音、三模式和弦指引与频谱验证
    从仓库上一版 V034 更新到已配套烧录并校验的 V047。
    增加 score/2 四音和弦、自动/逐音/固定 BPM、手机新曲上传、128键映射、
    30秒数字PCM录音及FFT/自适应李萨如；修正ADS/I2S受损脚避让，鼓垫增益约+6dB。
    补齐 V034→V047 增删说明、架构与 AI 交接、当前接线、资源/延迟与32路展示说明。
    保留已验证二进制和原始构建/实机报告，并提供可迁移的身份与和弦/编码核验入口。
    已核验生产输入/固件哈希，三项和弦RTL、两份曲谱及七项非法和弦拒绝检查通过。
    示例谱供手机手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
    [32路频率核对表.csv]
